marcutudor79/Positive-voltage-regulator/Voltage_regulator_documentation.docx

Project 1

Positive Voltage Regulator

Student: Mărculescu Tudor Coordinators: As. Prof. Laurențiu Teodorescu

Group: 431F Ș.l. Marghescu Cristina

# 1. Project requirements

It is required to design a positive linear voltage regulator with discrete components, with the following specifications:

* Supply voltage between 22 ÷ 25 [V];
* Programmable output voltage 15 ÷ 17 [V];
* The output current through the load between 0 ÷ 34 [mA];
* Short circuit protection of the output terminals with foldback current limiting circuit.
* Overvoltage protection of the output terminals.
* The line regulation factor S=(ΔV_i)/(ΔV_o)|_(RL) ≥ 87.
* Load resistance Rl= (Vo_max)/(Io_max)=500 Ω.

The output impedance of the regulator3 Ω.

The voltage regulator is an electronic device that is supposed to maintain a constant voltage at its output terminal. However, in practice, the voltage regulator reduces drastically the voltage ripple at its input. Therefore, the main characteristic of a voltage regulator is the regulation factor, which tells how much the output voltage changes with respect to the change in the input voltage S=(ΔV_i)/(ΔV_o)|_(RL) . The focus of designing this circuit is to obtain a good enough regulation factor, higher than 100.

The presented regulator is a linear feedback regulator, that employs an active series pass transistor which is controlled by a high gain differential amplifier, which compares the output voltage with a reference voltage and adjust the control device in order to maintain a constant output voltage. It also has the capability to change its output voltage in the range of 15 to 17 V and has a maximum output current of around 34 mA.

# 2. The block diagram of the circuit

The block scheme of the regulator contains at least three main components: the voltage reference, the control element, and the error amplifier. These are essential for the regulator to be able to regulate the voltage. In addition, there is an overcurrent protection that prevents the accidental damage to the series pass transistor, namely the control element. There is also an overvoltage protection and a sampling circuit that provides feedback to the error amplifier, as seen in figure 1.

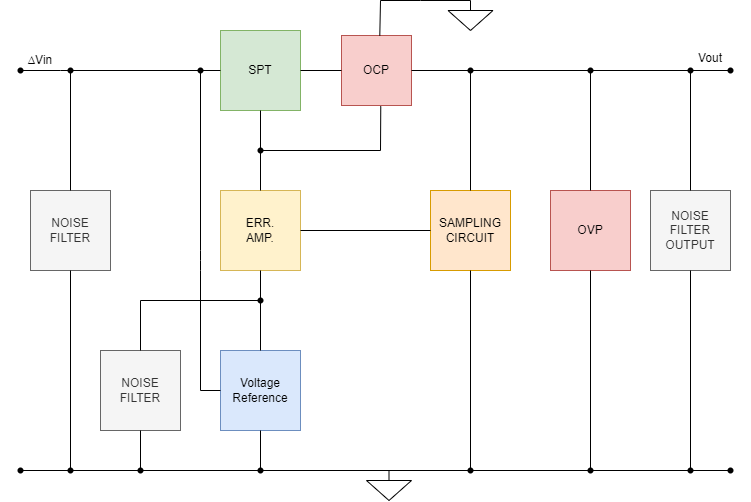
[picture p1: figure]

Figure 1 Block scheme of the positive voltage regulator

The full description of each block in the scheme is to be given in the following paragraph:

- The control element (SPT) is a series pass transistor, that is situated between the unregulated supply and the regulated output. It is controlled by the error amplifier such that to pass a specific a load current, to have the desired output voltage drop on the load.
- The error amplifier (ERR. AMP.) is a differential stage that controls the series pass transistor. It is also connected to the voltage reference and the sampling circuit because this part of the circuit is supposed to compare the reference, which is equal to the desired regulated output voltage and the actual sampled output voltage, that may vary with the different resistances of the loads connected at the output of the voltage regulator.
- The over current protection (OCP) is a stage that is connected in between the series pass transistor and the load. It is supposed to protect the control element from a very high current that can pass through if the output terminals are accidentally short circuited. It also has a special behavior, called foldback, that maintains a lower short circuit current than the maximum current that can pass through this protection. This is an innovative way to implement such a circuit, since the series pass transistor may dissipate a high power for a very short amount of time, but after that it is advised to lower it in order to not overheat the component.
- The over voltage protection (OVP) is the part of the circuit that will not let the output voltage exceed the 18.4V threshold. This circuit is implemented since the purpose of the circuit is to stabilize the voltage up to 17V. It may occur in certain scenarios that the output voltage might spike higher than 17V, therefore a transistor that can sink a current parallel to the load is needed to lower the actual output voltage through the load.
- The sampling circuit is a simple voltage divider that allows the user to program the output voltage by means of a potentiometer. This circuit also has the purpose to employ a negative feedback loop, that helps the overall functioning of the regulator. Because of the feedback, the regulator is able to achieve a higher resistance to noise and the ability to maintain a stable output voltage whatever the resistance of the connected load.
- The voltage reference is the part of the circuit that offers to the error amplifier a constant voltage to which the differential circuit compares the sampled output voltage. This is a critical part of the circuit, since the voltage drop across it must be as stable as possible, for the regulator to have a high regulating factor.
- The noise filters are parts of the circuit that protect that remove the noise from the input and the output of the voltage regulator. They both behave as RC filters with different cutoff frequencies.

CAUTION! Since this circuit employs an over current protection OCP, the resistance of the load must be higher than the minimum allowed resistance through which can pass the maximum allowed current by the OCP.

3. Electrical scheme

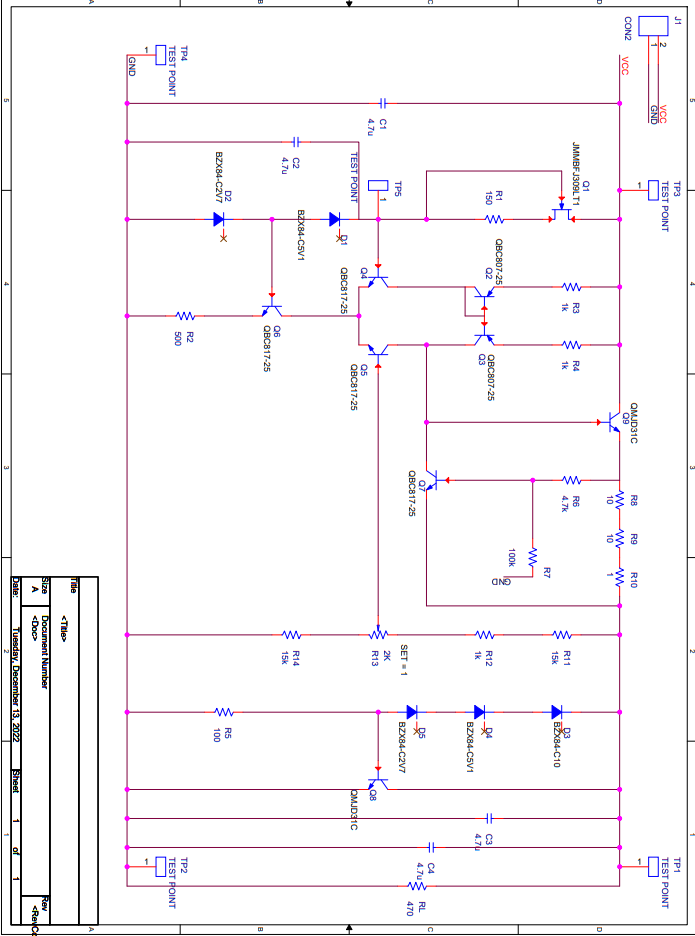
[picture p2: figure]

## 3.1 Details about each block of the circuit

- The voltage reference is the part of the circuit that has a stable voltage drop across at it, even if the input voltage varies. It is used as an input to the non-inverting pin of the differential voltage amplifier, as seen in figure 2.

For this part of the circuit, the Zener diodes D1 and D2, had to have around 7.8V of voltage drop across them, so the BZX84-C5V1 with a Vz = 5.1V and BZX84-C2V7 with a Vz = 2.7V were chosen. In order to obtain those specific Vz voltages, the Zener diodes need to have a minimum current Imin = 5mA to enter the breakdown region. The Imin current will be ensured by Q1, a JFET transistor, JMMBFJ309LT1 that is biased in such a way to obtain a current of 5.6 mA on the branch with the D6 and D2.

It is critical that the current through D6 and D2 does not vary, because if the voltage drop varies on them, then the output voltage will vary too. This is why a simple resistor, on this branch of the circuit, was not acceptable in order to obtain a high regulation factor.

The choice of having around 5.6 mA through the Zener diodes was made since it can be seen on the I-V characteristic that the voltage is more stable if a slightly higher than 5 mA current is passed through them.

- The error amplifier is the part of the circuit that acts as a comparator between the voltage reference and the output voltage of the regulator. It is used in order to obtain a stable output voltage. The error amplifier is composed of a current mirror, represented by Q2 and Q3 PNP transistors, BC807-25, that ensures equal currents that passing through Q4 and Q5 NPN transistors, BC817-25, which compose the differential amplifier stage. They are low power PNP and NPN transistors because the power dissipated by them does not exceed the maximum power that can be dissipated by such transistors according to the data sheet.

The current mirror is an important part of the circuit because it guarantees the fact that the differential amplifier has a higher CMRR and higher bandwidth. The higher CMRR is especially important, because in a noisy environment, this part of the circuit is able to reject some picked up noise that might affect the reference voltage and the sampled output voltage.

To properly equalize the currents that enter Q4 and Q5, transistors Q2 and Q3 need to be matched. However, due to the fact that these are discrete components, and they could have high variations in their process parameters, such as the base-emitter voltage, the resistors R3 and R4 were added in order to neglect those variations. They are both SMD0805.

The error amplifier has at the non-inverting input the voltage reference and at the inverting input the sampled output voltage. By solving this part of the circuit, we can see that the sampled output voltage should be equal with the reference voltage, so this will be ensured by passing to the control element a variable current.

- The control element Q9, MJD31C, is a high power NPN transistor that is biased by the error amplifier. It ensures a proper output current so that the voltage drop across the load is a stable voltage of a particular desired value, in this case, between 15V and 17V. It is proved in the calculus provided below that the dissipated power by this transistor does not exceed its maximum power.
- The over current protection is a circuit made from three sensing resistor R8, R9 and R10, the voltage divider composed of R6 and R7 and the Q7 NPN transistor BC817-25. When the current through the sensing resistors exceeds 60 mA, the Q7 transistor is going to be biased into RAN, therefore sinking the current that would have entered the base of Q9 the control element. This behavior makes Q9 conduct less current, therefore ensuring a maximum allowable current through the control element when the output terminals are short circuited. This circuit also implements the foldback behavior, which makes the short circuit current lower than the maximum allowable current.

Isc < Imax

- The over voltage protection is composed of three Zener diodes BZX84-C10, BZX84C-C5V1, BZX84-C2V7 that do not allow the output voltage to reach a higher value than 18.4V. When reaching this value, the Zener diodes will start conducting and the sense resistor R5 will have a voltage drop across it equal the base emitter voltage of the transistor Q8. If it was previously in the blocking state, the transistor will conduct the “excess” current from the load resistor, therefore stabilizing the voltage drop across it at the maximum 18.4V.
- The sampling circuit is the negative feedback loop for the differential amplifier. It is composed of resistor R11, R12, R14 and the potentiometer R13. Their values have been calculated such that by moving the potentiometer into its minimum value, the output voltage will be equal to 15V and when we move it to the maximum value, the output voltage will be equal to 17V. This allows the output voltage to be programmable.
- The noise filters at the input are the two capacitors at the input C1 that is connected in parallel with the input of the circuit and C2 that is connected in parallel with the reference voltage. They behave as RC filters, where the cutoff frequency of the filter with C1 is dependent on the output impedance of the voltage supply source.

f cutoff = 1/(2πRC)

where C is equal to the capacitance of C1 = 4.7 μF and R is equal to the output impedance of the voltage source

The cutoff frequency of the voltage reference filter has a higher cutoff frequency than the one at the input, since the impedance of R is the impedance of the conductor between D1 and C1.

f cutoff = 1/(2πRC) = 17 kHz

where C is equal to the capacitance of C2 = 4.7 μF and R ≅ 1 Ω

- The noise filter at the output is composed of two parallel capacitors C3 and C4 having a capacitance equal to 9.4 μF. It acts as an RC filter having as R the output impedance of the regulator.

f cutoff = 1/(2πRC) = 17 kHz

## 3.2 Calculus of DC bias, Open-loop voltage gain, closed loop impedance, and the regulation factor

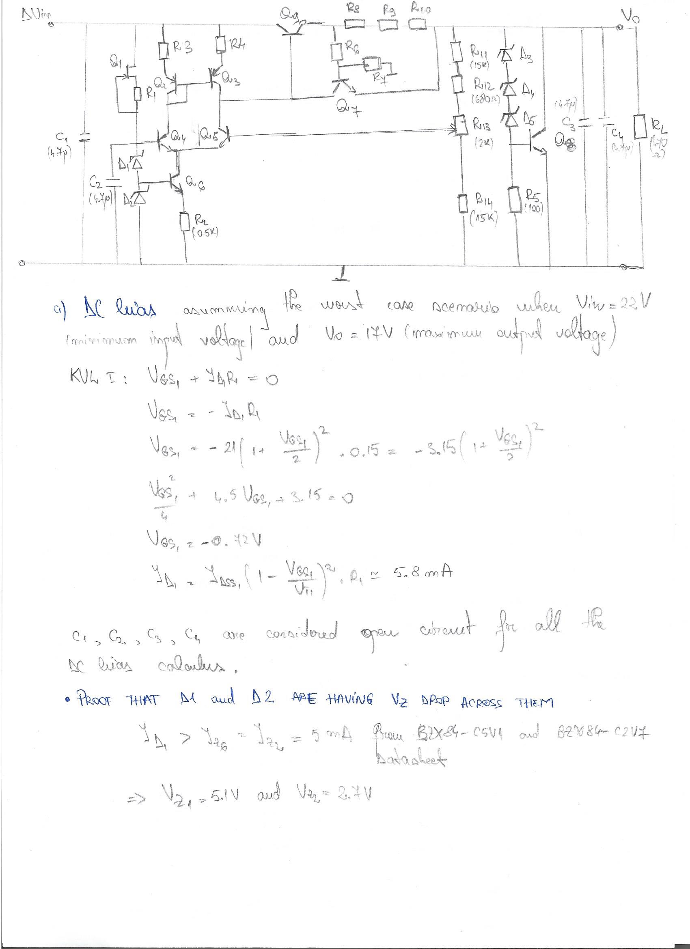
[picture p3: figure]
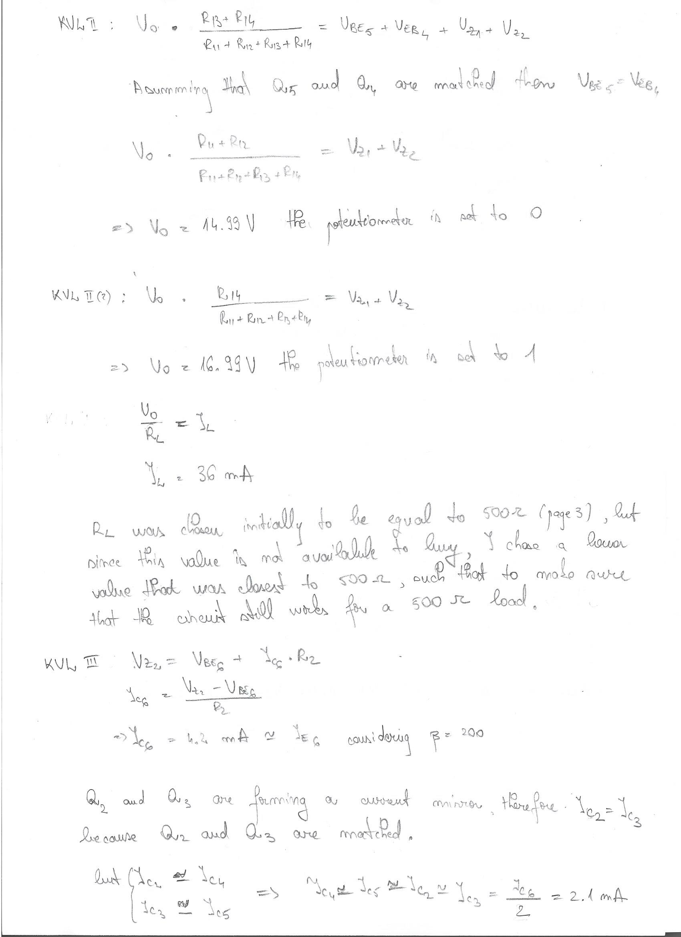
[picture p4: figure]
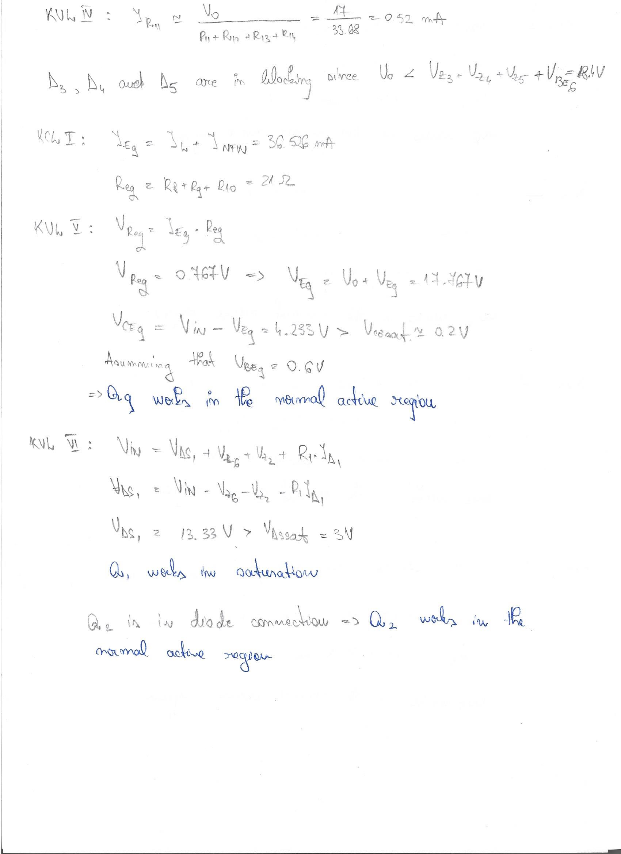
[picture p5: figure]
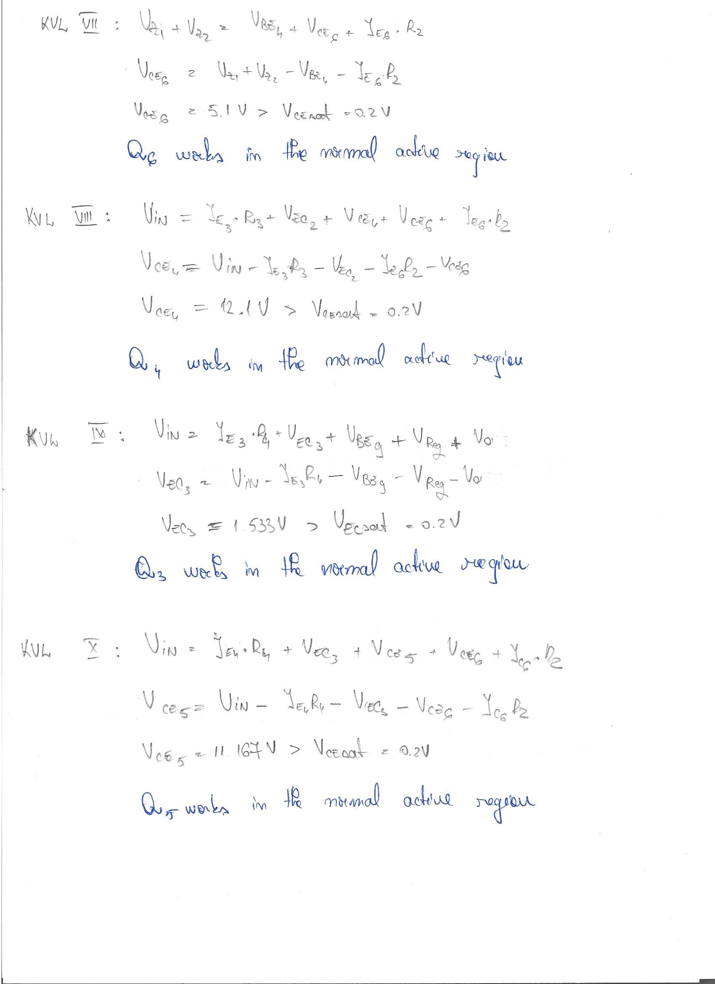
[picture p6: figure]
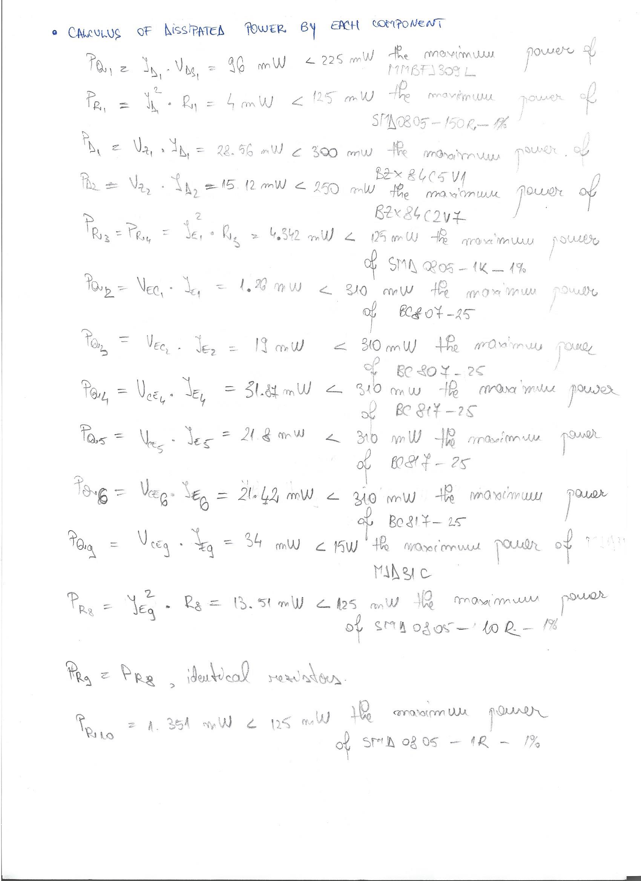
[picture p7: figure]
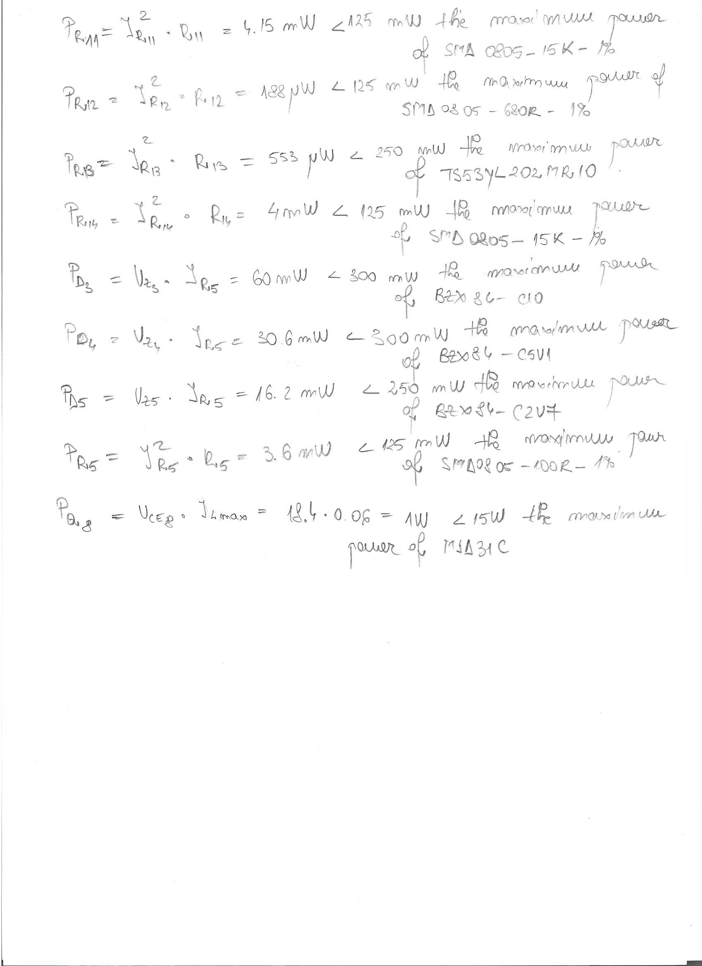
[picture p8: figure]
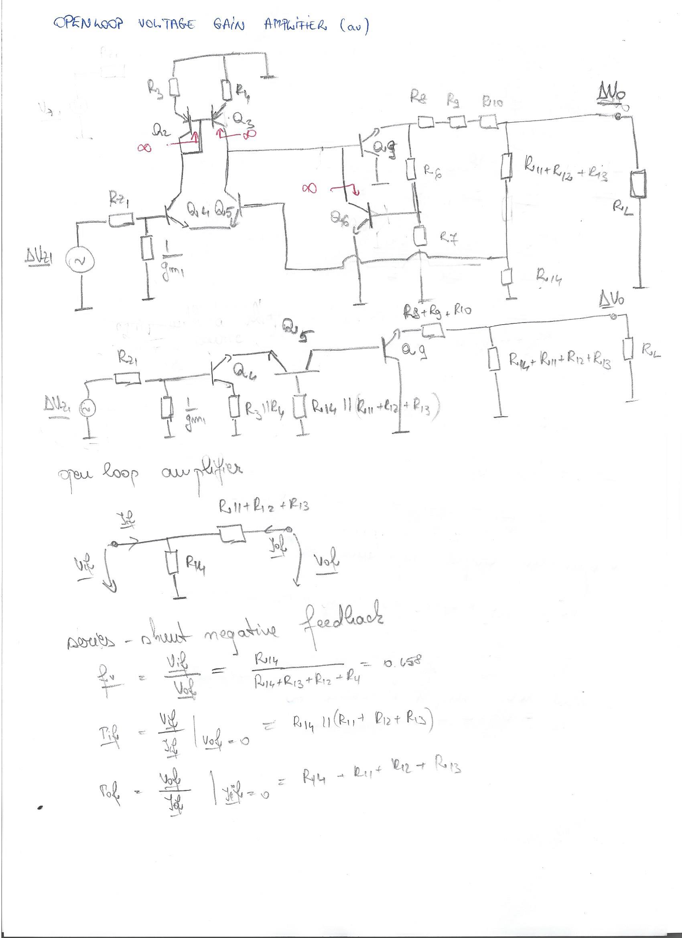
[picture p9: figure]
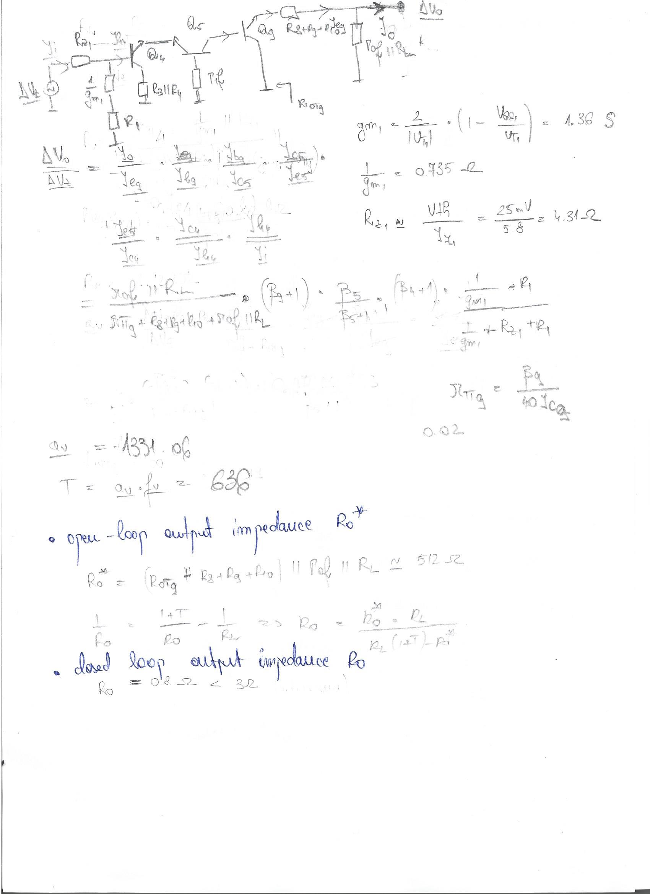
[picture p10: figure]
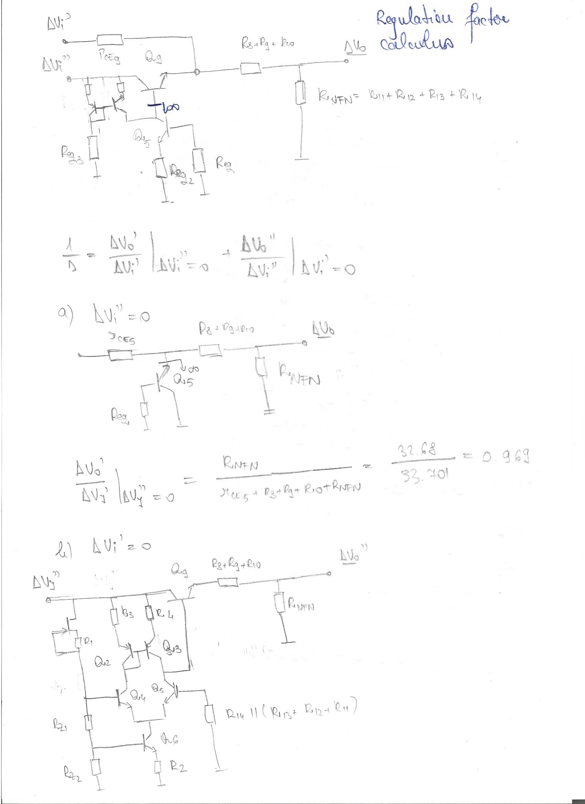
[picture p11: figure]
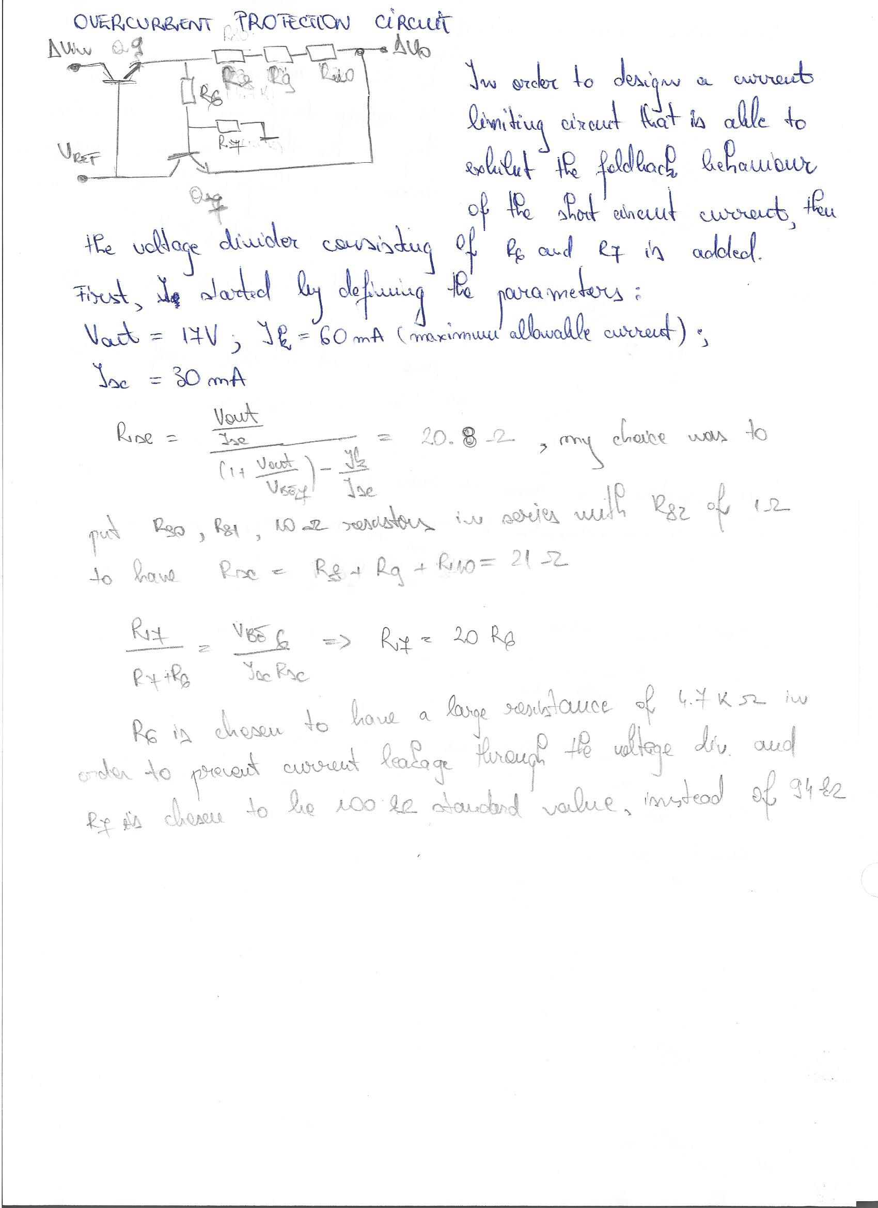
[picture p12: figure]

## 3.3 Calculus of the over current protection OCP

## 3.4 Calculus of the over voltage protection OVP

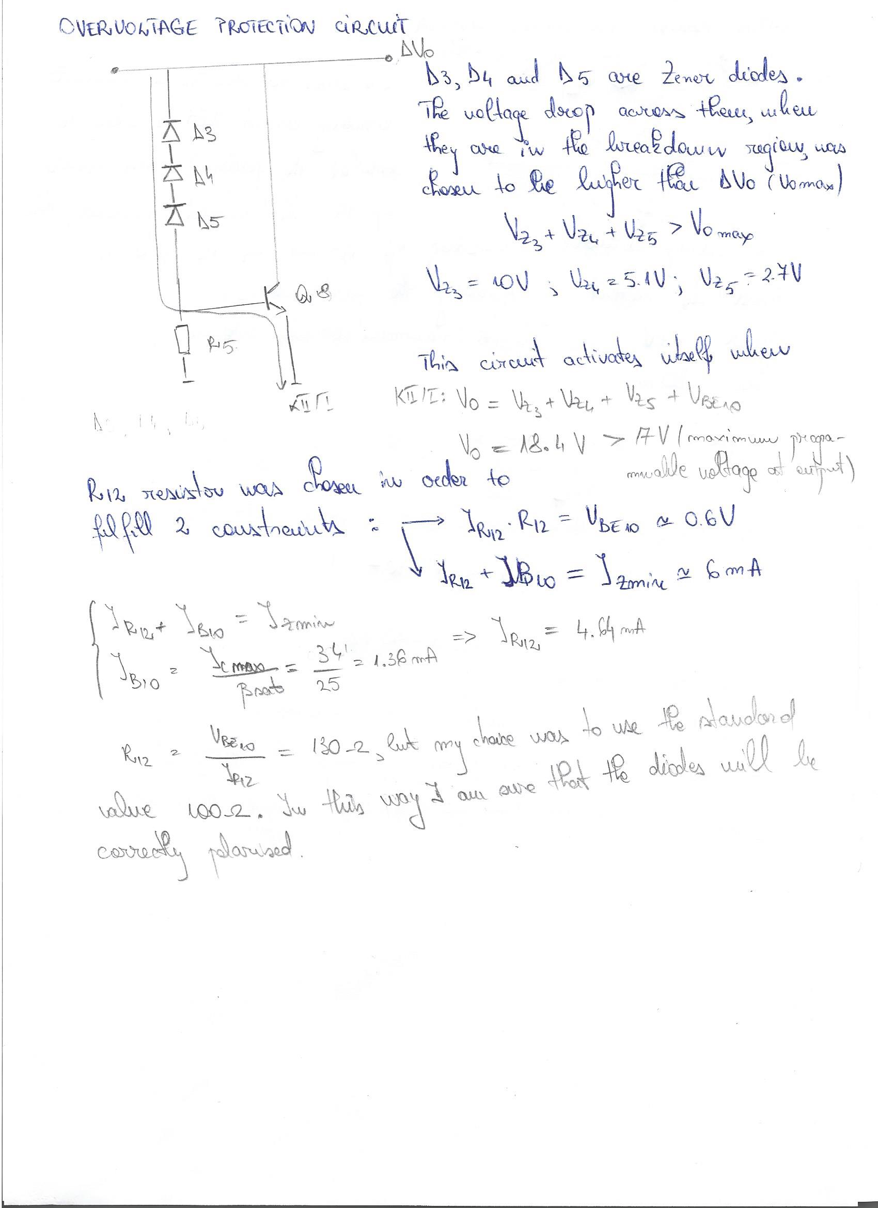
[picture p13: figure]

# 4. SPICE simulations of the circuit

## 4.1 DC bias

The simulation in figure 2 is a bias point one. It is meant to show the overall functionality of the circuit. It is proved that each bipolar junction transistor is working in RAN and the FET transistor is in saturation. The power on each component is also shown, and proves that the maximum power is not exceeded.

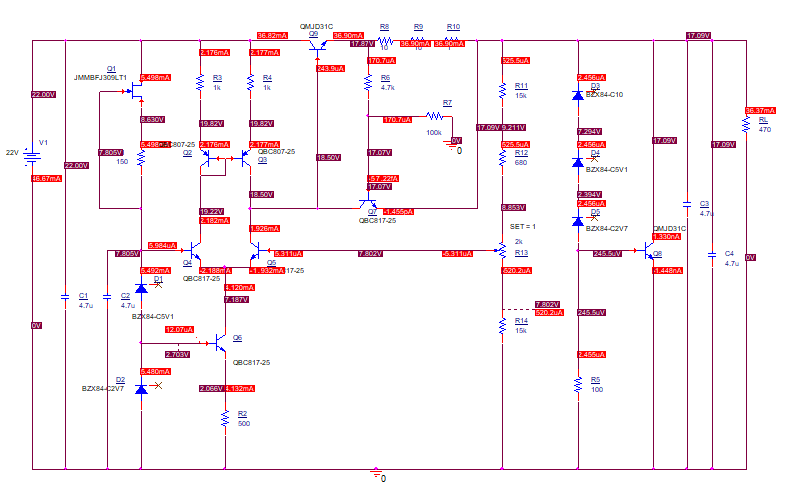
[picture p14: figure]

Figure 2 DC bias in the worst case scenario when Vin = 22V and Vout ≅ 17V

These two DC sweep simulations show that by setting the potentiometer at 0 respectively 1, the circuit can stabilize the voltage at 15V, respectively 17V, which are the required minimum and maximum programmable voltages.

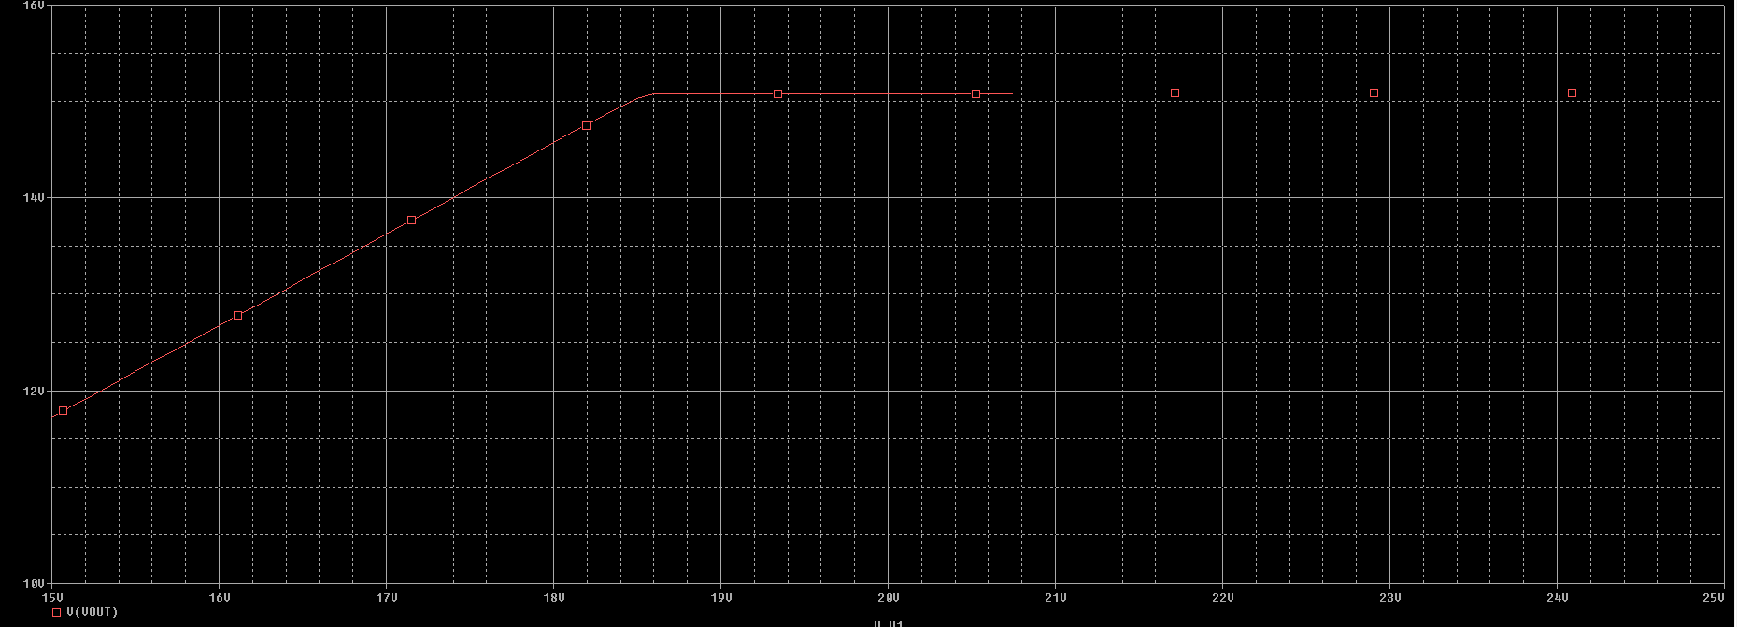
[picture p15: figure]

Figure 3 Minimum required programmable output voltage

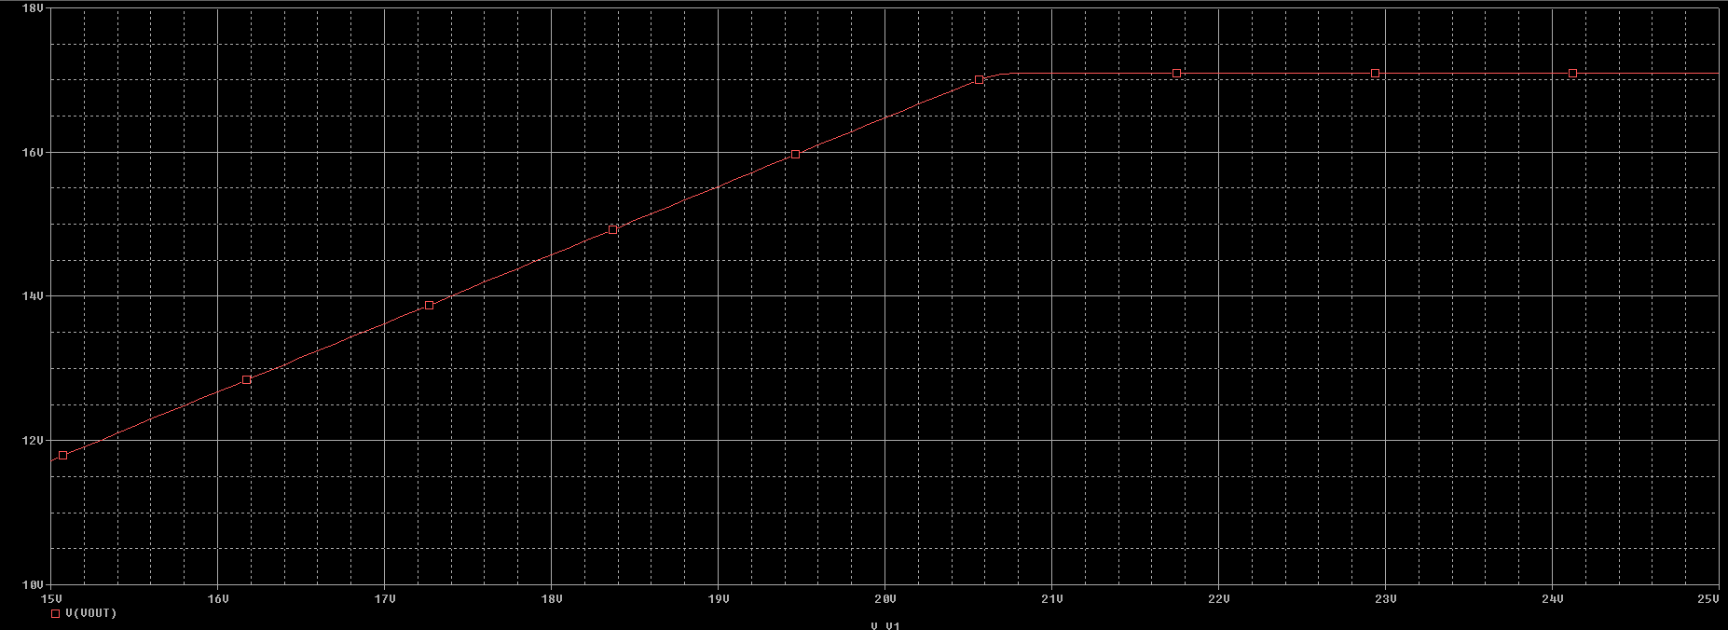
[picture p16: figure]

Figure 4 Maximum required programmable output voltage

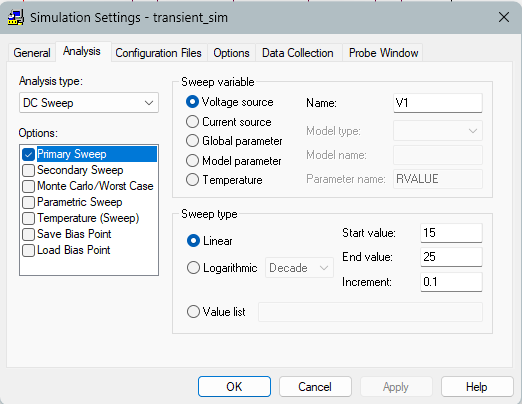
[picture p17: figure]

Figure 5 Maximum / minimum required programmable output voltage simulation settings

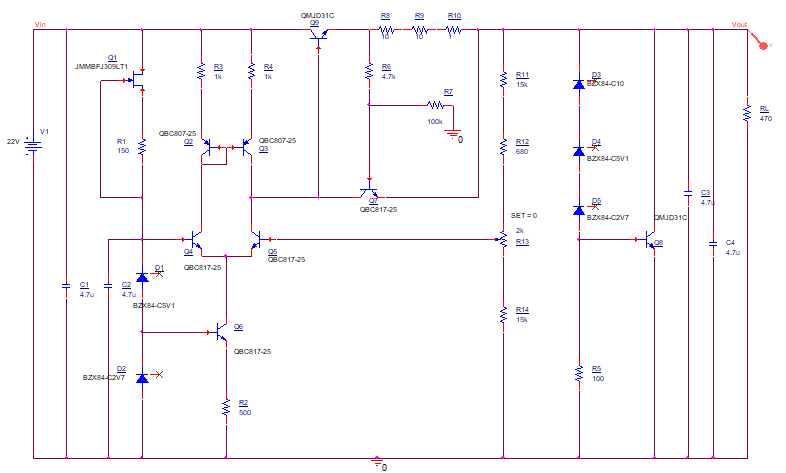
[picture p18: figure]

Figure 6 Maximum / minimum required programmable output voltage circuit configuration

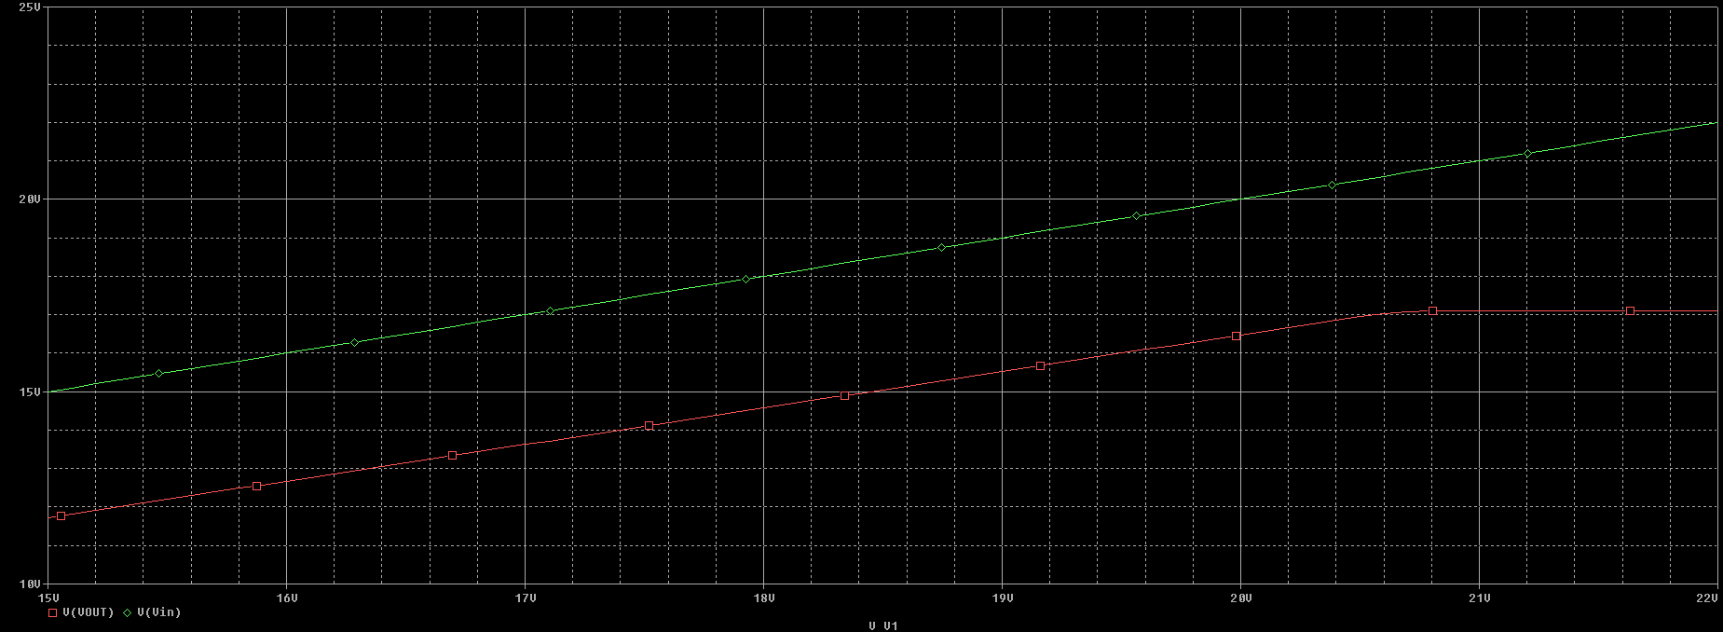
[picture p19: figure]

Figure 7 Worst case scenario when the input voltage is 22V and the output voltage is set to 17V

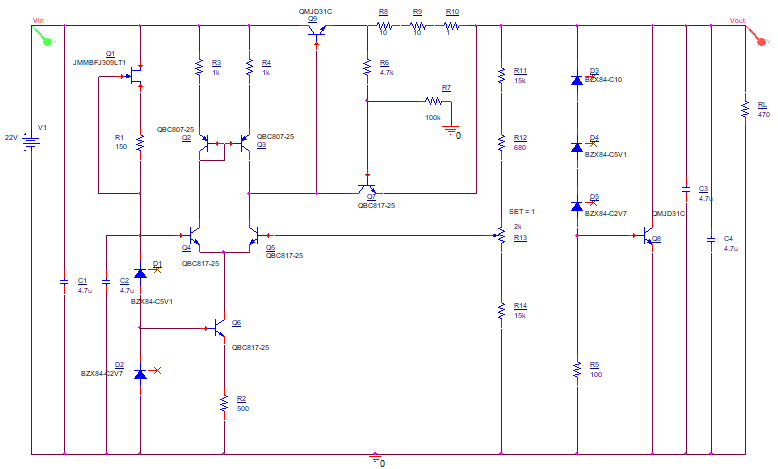
[picture p20: figure]

Figure 8 Circuit used in order to simulate the worst case scenario

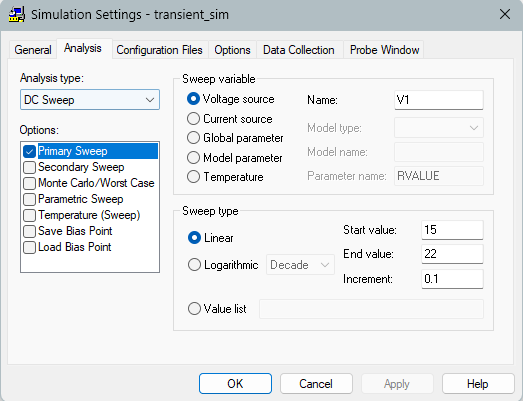
[picture p21: figure]

Figure 9 Simulation settings used to determine the output voltage in the worst case scenario

## 4.2 Stability (S)

The stability is obtained using a transient simulation on a sinusoidal generator. The obtained stability from the simulations is above 600.

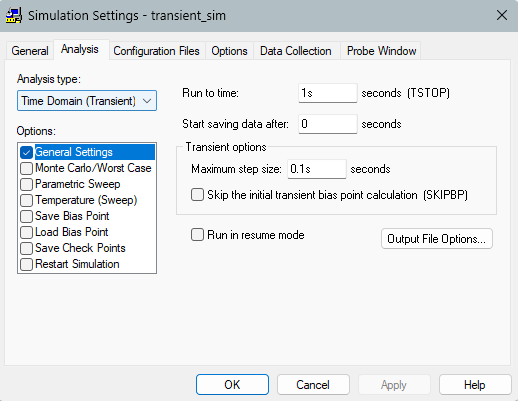
[picture p22: figure]

Figure 10 Settings for simulation in order to determine S

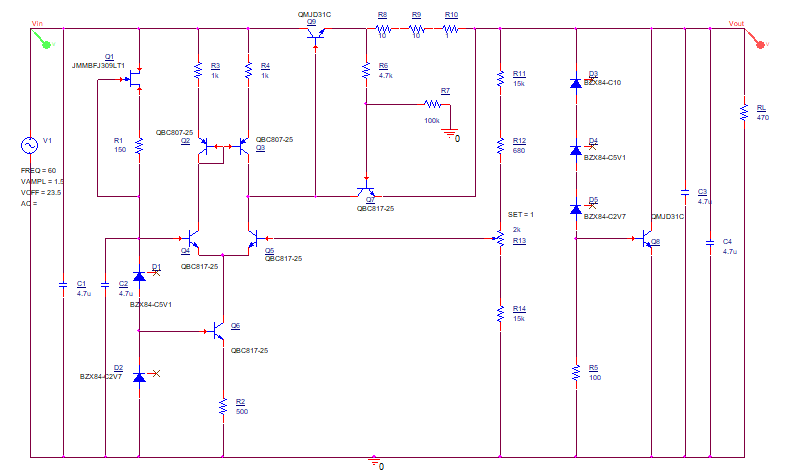
[picture p23: figure]

Figure 11 Circuit that was used in order to determine S

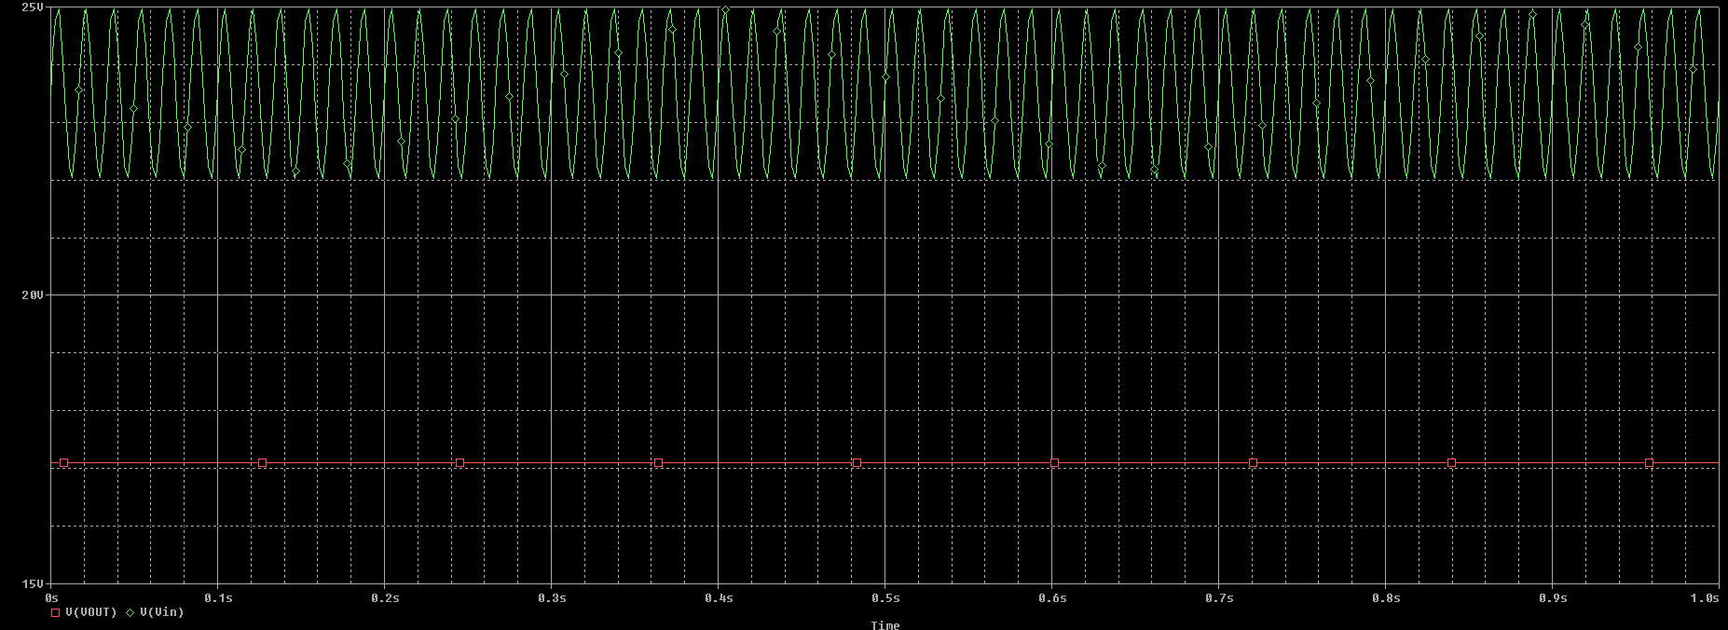
[picture p24: figure]

Figure 12 Variable input voltage(green) compared to the stable output voltage(red)

ΔV_i =3V

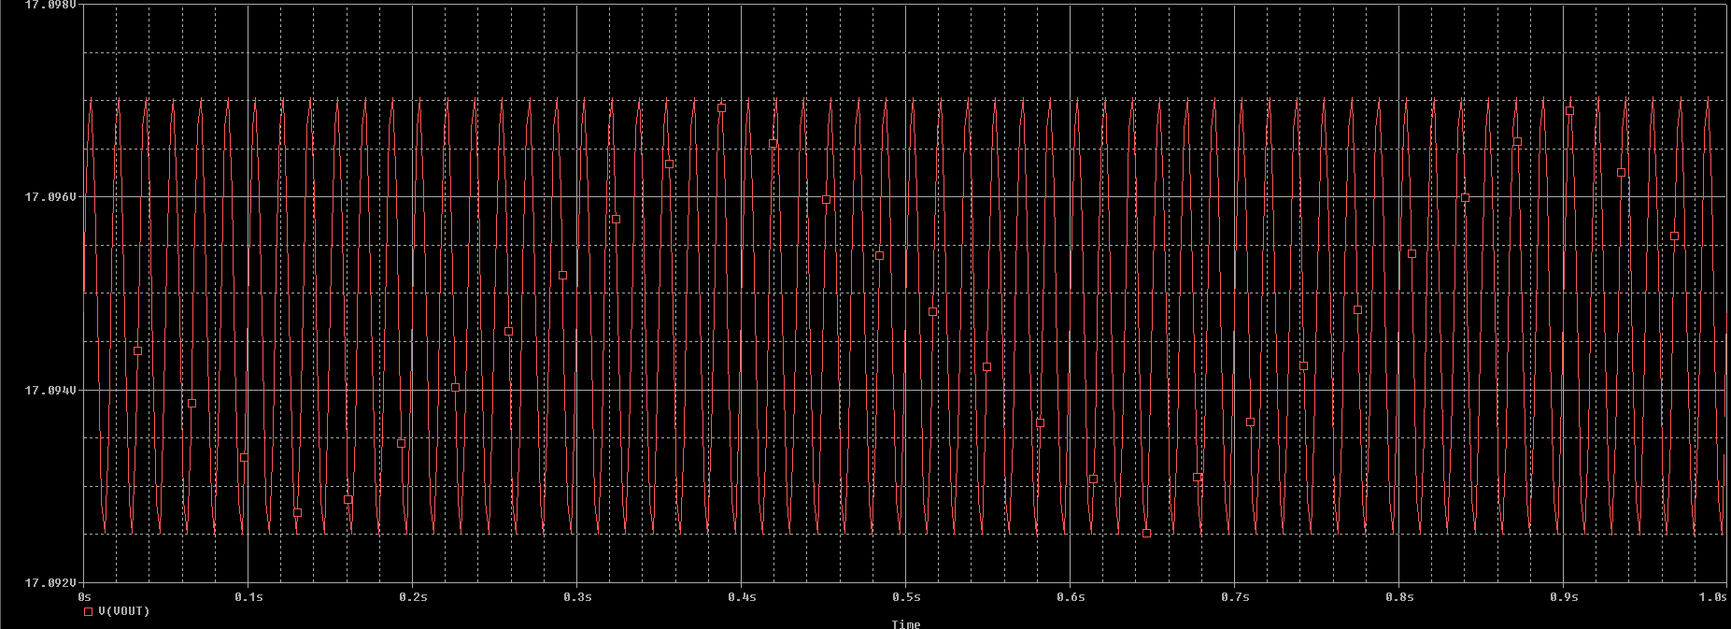
[picture p25: figure]

Figure 13 Actual variation of the output voltage

ΔV_0 = 0.004V

S=(ΔV_i)/(ΔV_o)|_(RL) =750

## 4.3 Closed loop output impedance

The simulation of the closed loop output impedance is not trivial since the circuit has a negative feedback loop. The schematic was modified to be able to simulate the variation of the output voltage when the output current varies between 34mA and 28mA.

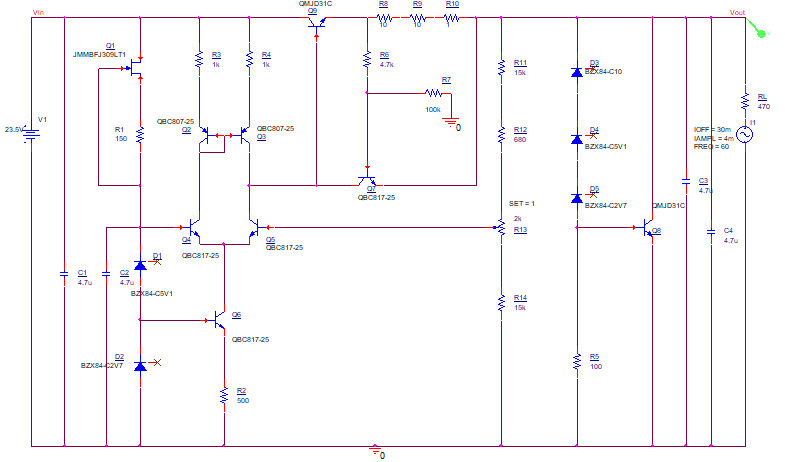
[picture p26: figure]

Figure 14 Circuit used in order to determine the closed loop output impedance

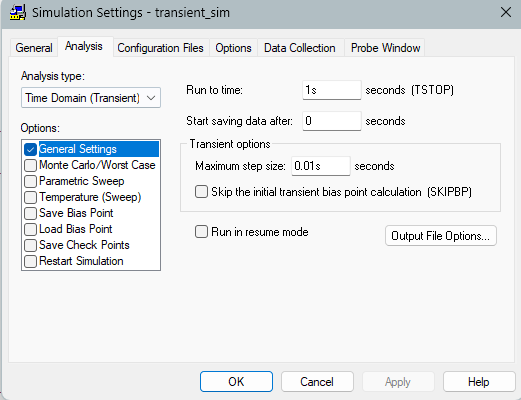
[picture p27: figure]

Figure 15 settings that were used in order to simulate

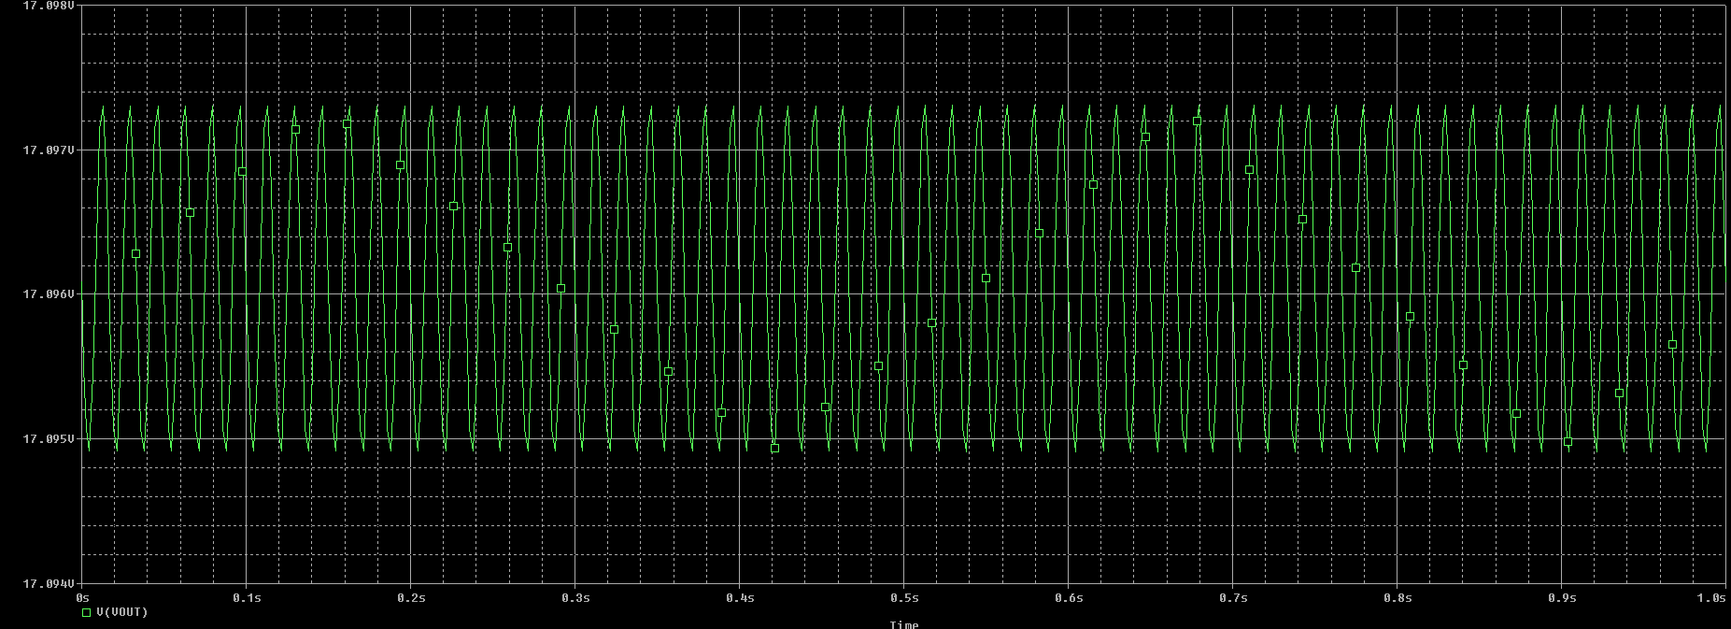
[picture p28: figure]

Figure 16 Variation of the output voltage

One can determine the variation of the output voltage by subtracting the maximum of the sinusoid, which is 17.097 by the minimum 17.095V and obtain a variation of 2mV.

ΔV_o =2 mV

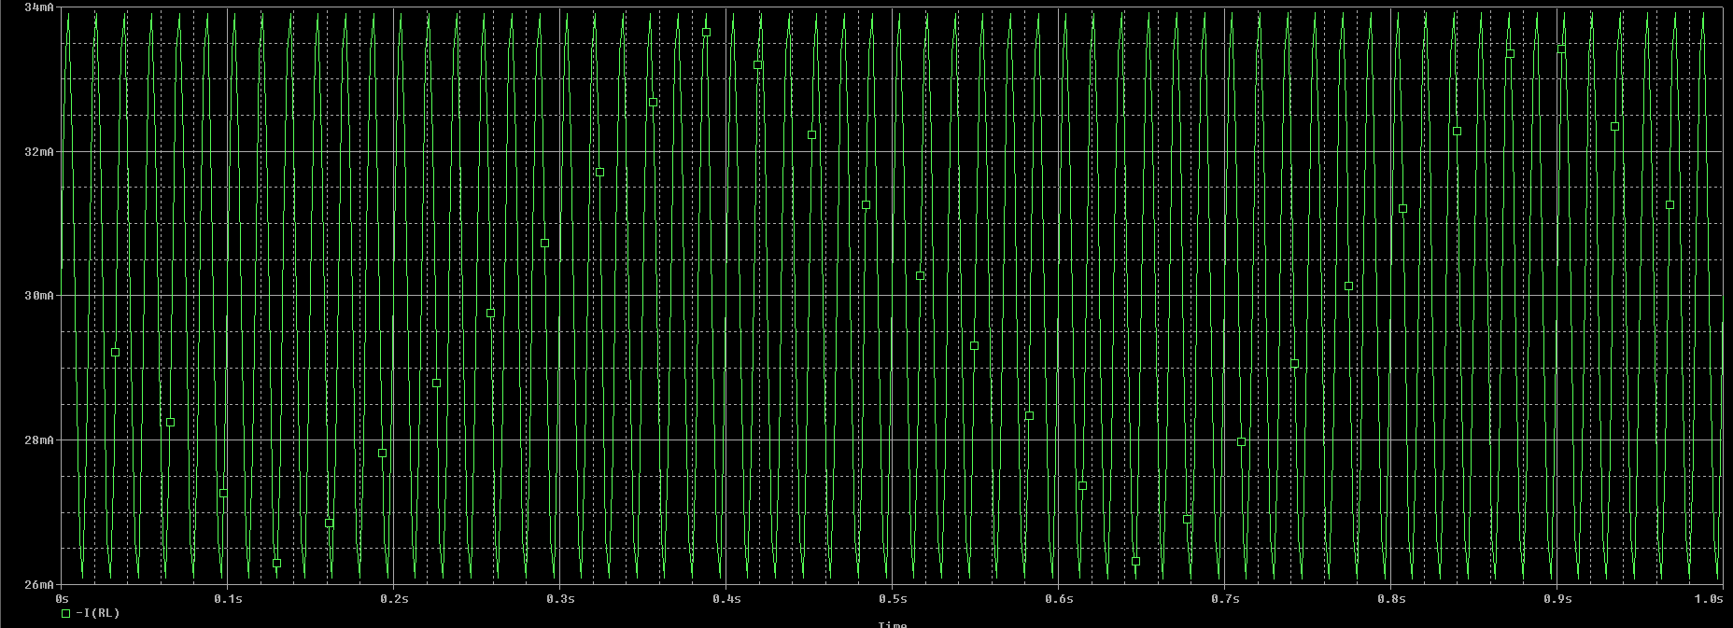
[picture p29: figure]

Figure 17 Variation of the output current

From the graph, one can determine that the variation of the output current is equal to 12 mA.
ΔI_o =8 mA

Ro= (ΔV_o)/(ΔI_o) = 0.25 ohm

## 4.4 Over current protection (OCP)

The simulation of the over current protection is done using a VPWL source at the output of the circuit that T1 = 20 has V1 = 17V and at T2 = 0 has V2 = 0V. This simulates a short circuit at the output of the circuit.

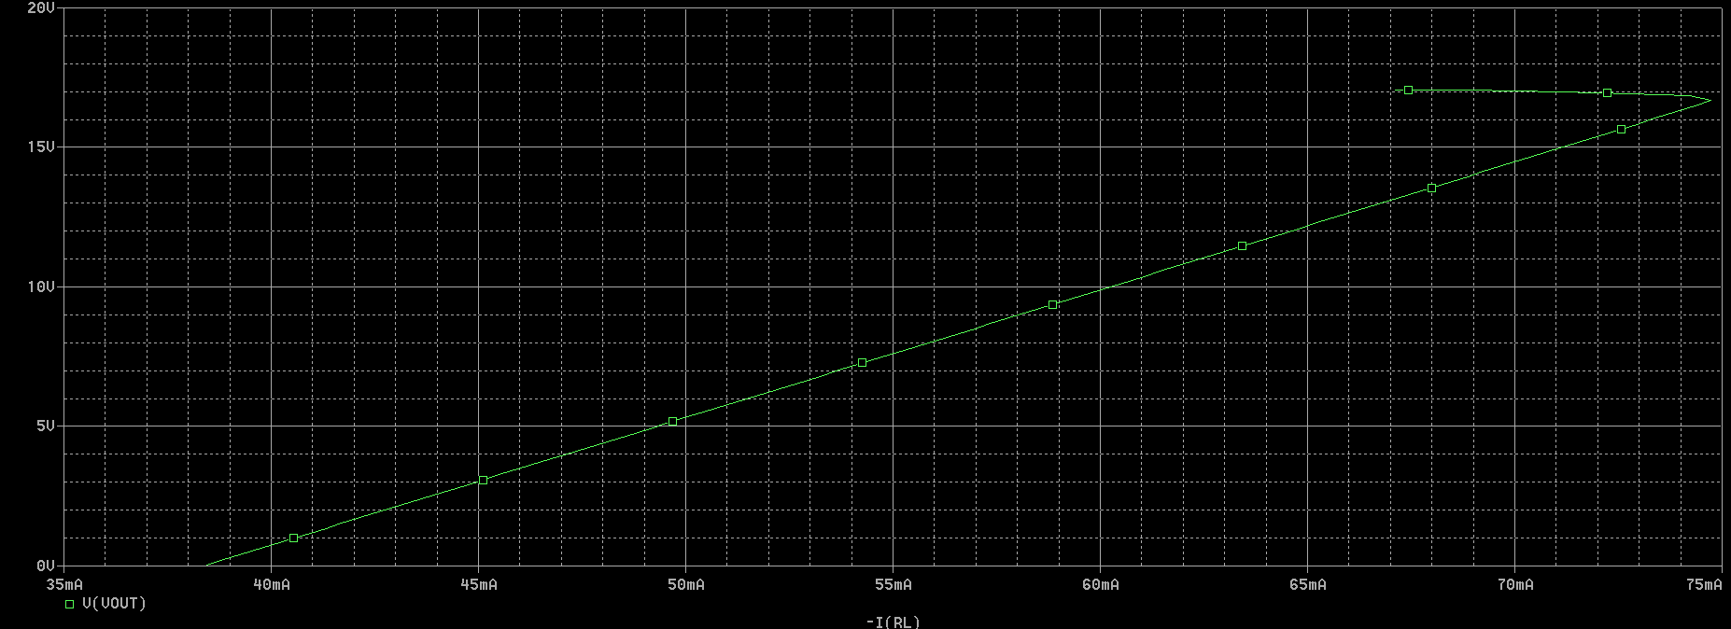
[picture p30: figure]

Figure 18 Overcurrent protection with foldback

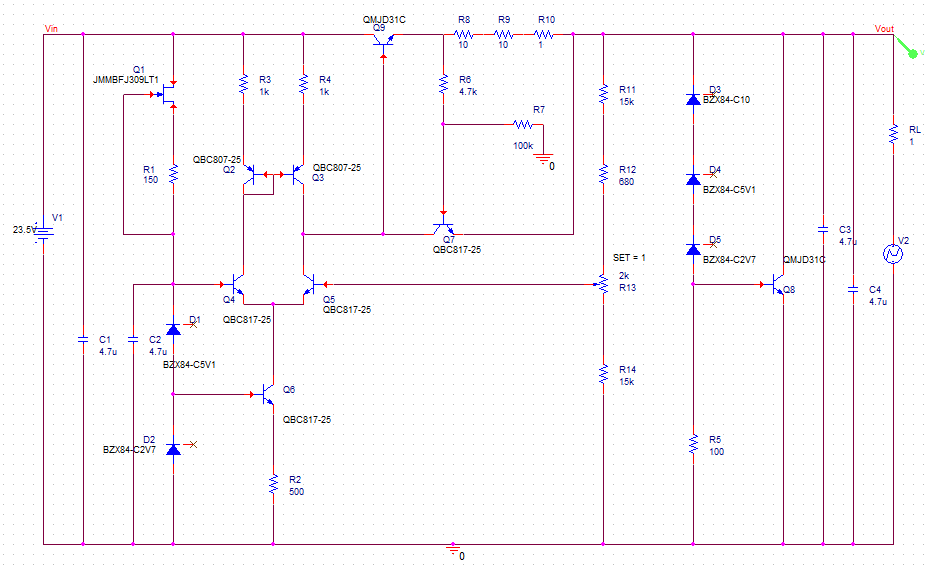
[picture p31: figure]

Figure 19 Circuit used in order to simulate the OCP

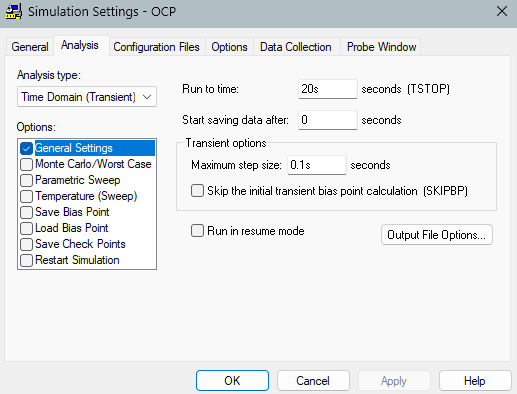
[picture p32: figure]

Figure 20 Settings used in order to simulate the OCP

## 4.5 Over voltage protection (OVP)

The simulation of the over voltage protection is done using a VDC source at the input and by modifying the potentiometer in such a way to have an output regulated voltage higher than 18.4V. Therefore the value of the potentiometer is changed to 5k. This is a DC sweep simulation of the input voltage source between 15V and 25V.

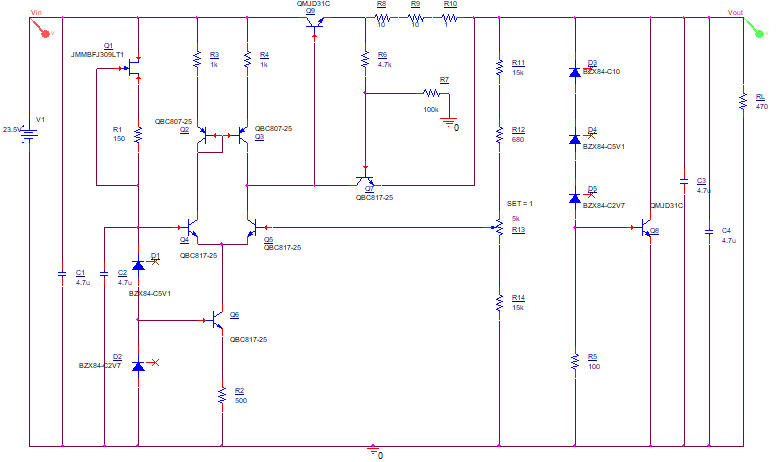
[picture p33: figure]

Figure 21 Circuit used in order to simulate the OVP

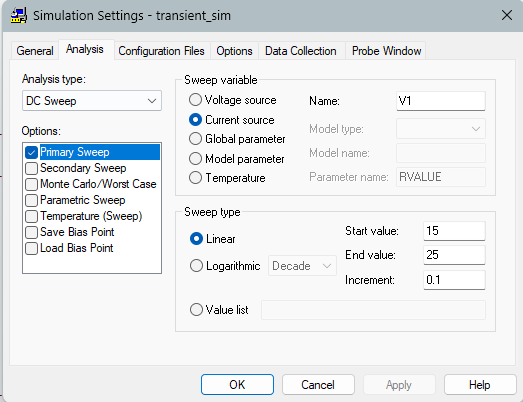
[picture p34: figure]

Figure 22 Settings used in order to simulate the OVP

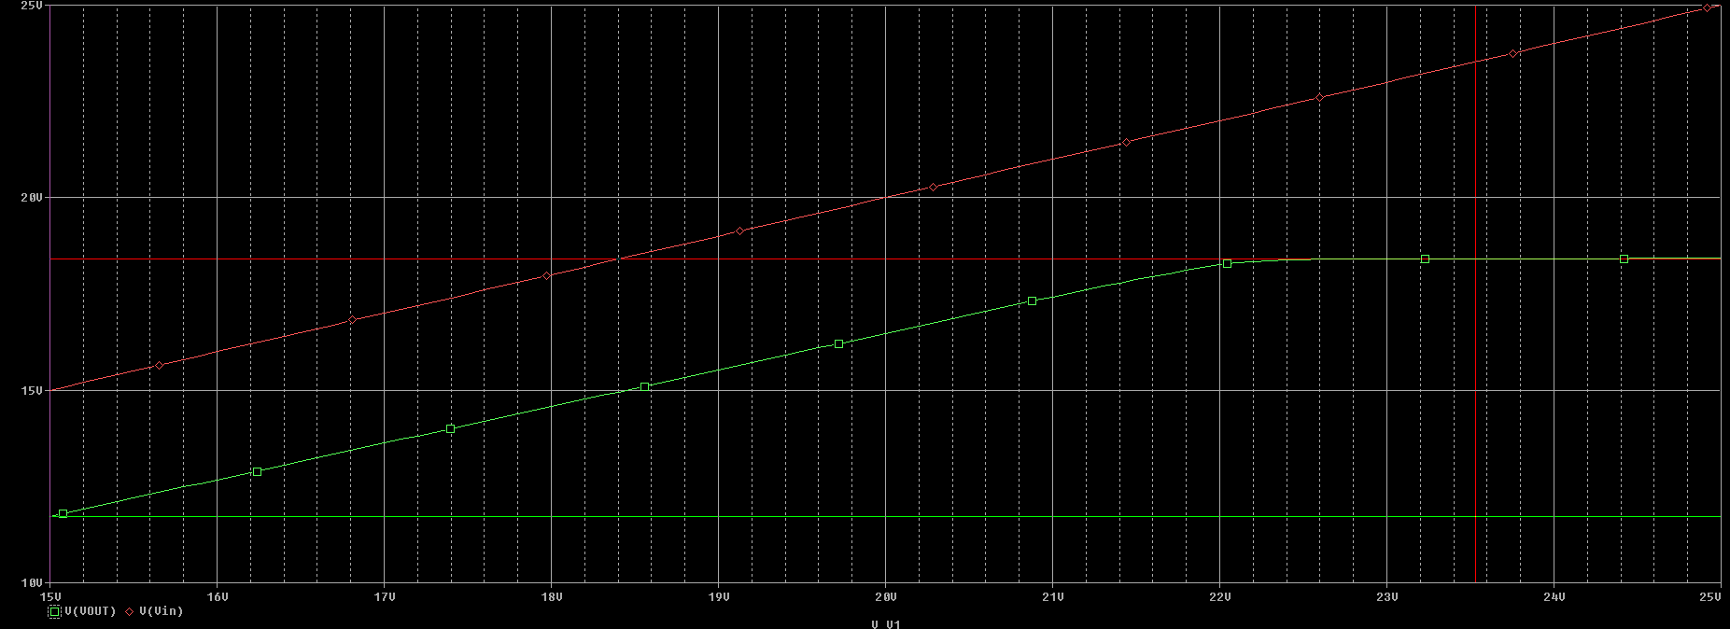
[picture p35: figure]

Figure 23 Output voltage(green) that is limited to 18.4V compared to the input voltage(red)

One can see that the output voltage becomes limited at the 18.4V. This is due to the fact the voltage drop across the Zener diodes in the OVP is 17.8V summed with the voltage drop across the base-emitter of the Q10 when it starts to conduct.

# 5. Conclusions

The purpose of the designed circuit was achieved. It was demonstrated first by means of calculus of all the parameters of the circuit and secondly by simulating them in PSpice in order to demonstrate the correctness of the calculus. Since I did not take into consideration high order effects, some of the obtained values are slightly different in the simulation.

# 6. Layout and mounting map

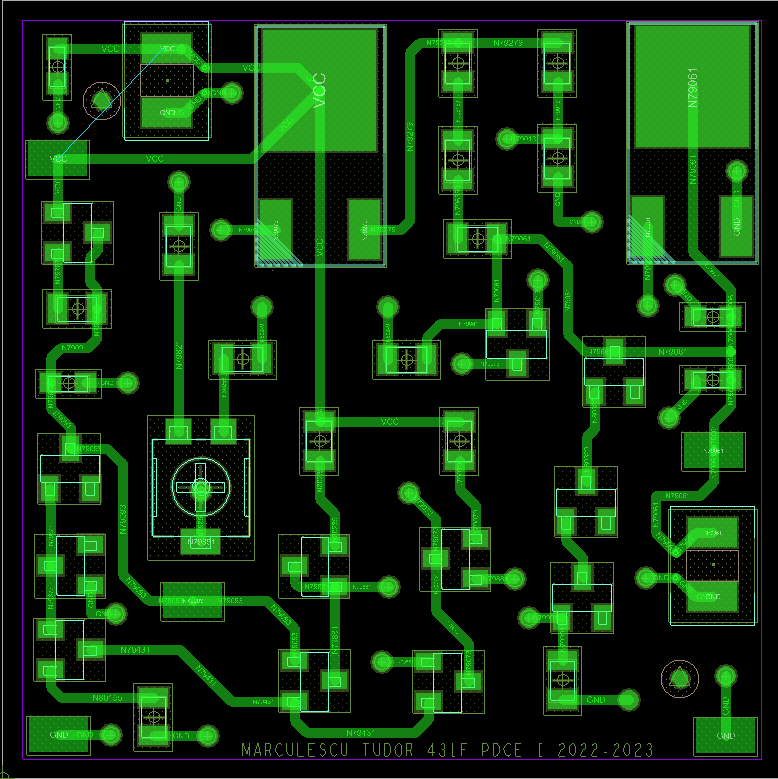
[picture p36: figure]

Figure 24 TOP layer view of the PCB

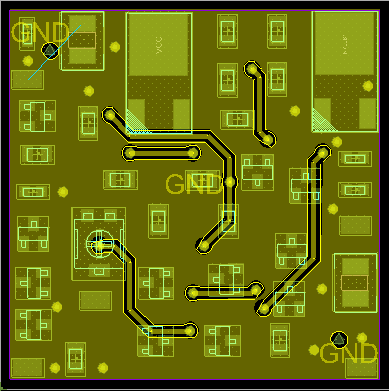
[picture p37: figure]

Figure 25 BOTTOM layer view of the PCB

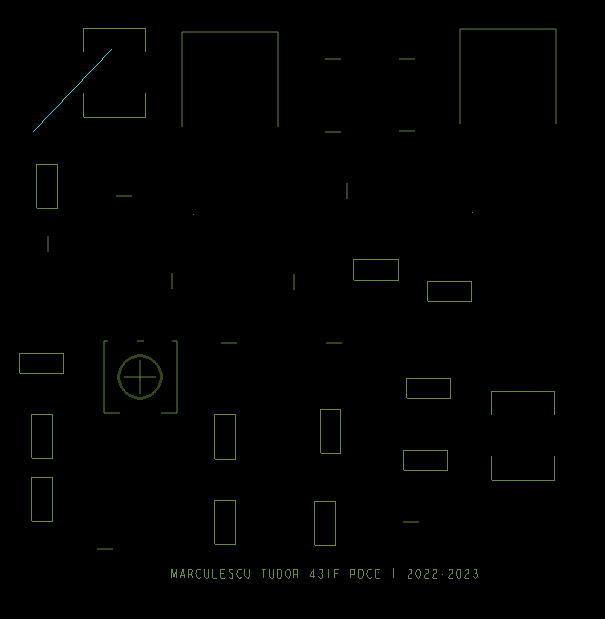
[picture p38: figure]

Figure 26 Silkscreen TOP layer view of the PCB

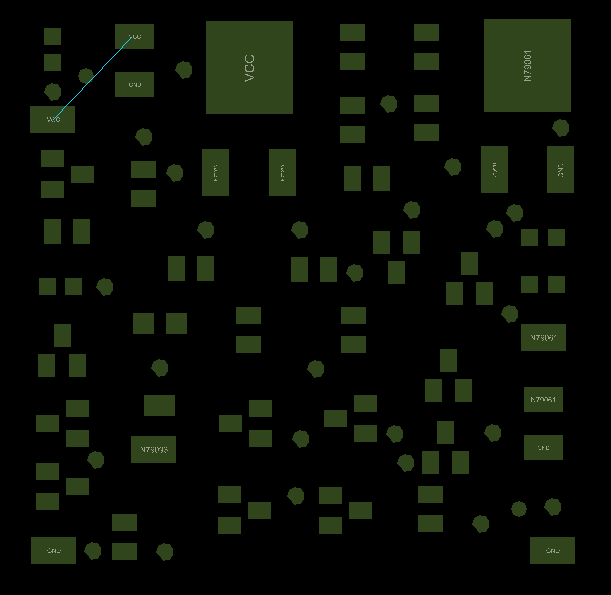
[picture p39: figure]

Figure 27 Soldermask TOP view of the PCB

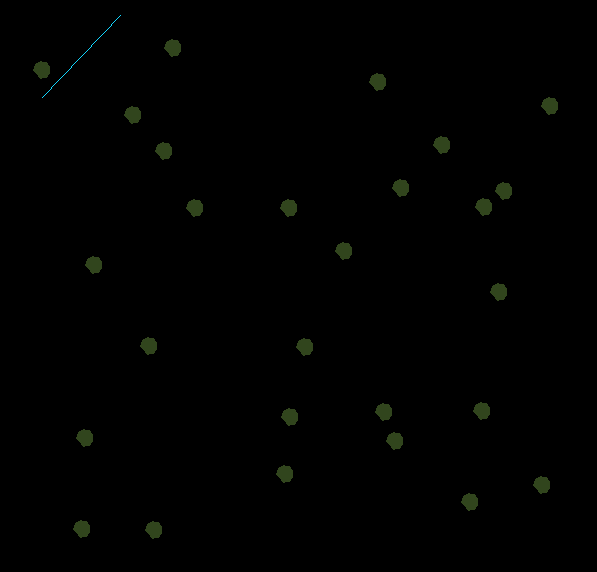
[picture p40: figure]

Figure 28 Soldermask BOT view of the PCB

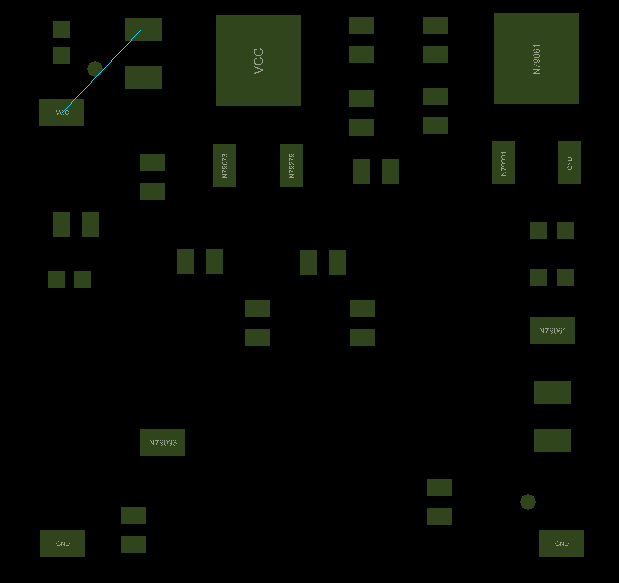
[picture p41: figure]

Figure 29 Soldepaste TOP view of the PCB

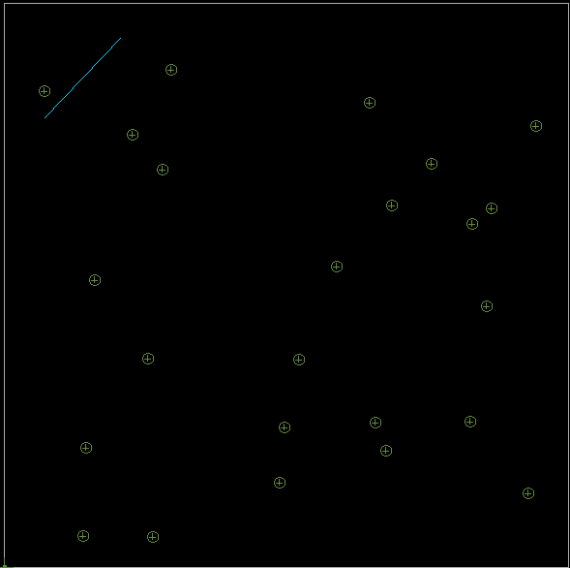
[picture p42: figure]

Figure 30 Mechanical layer view of the PCB

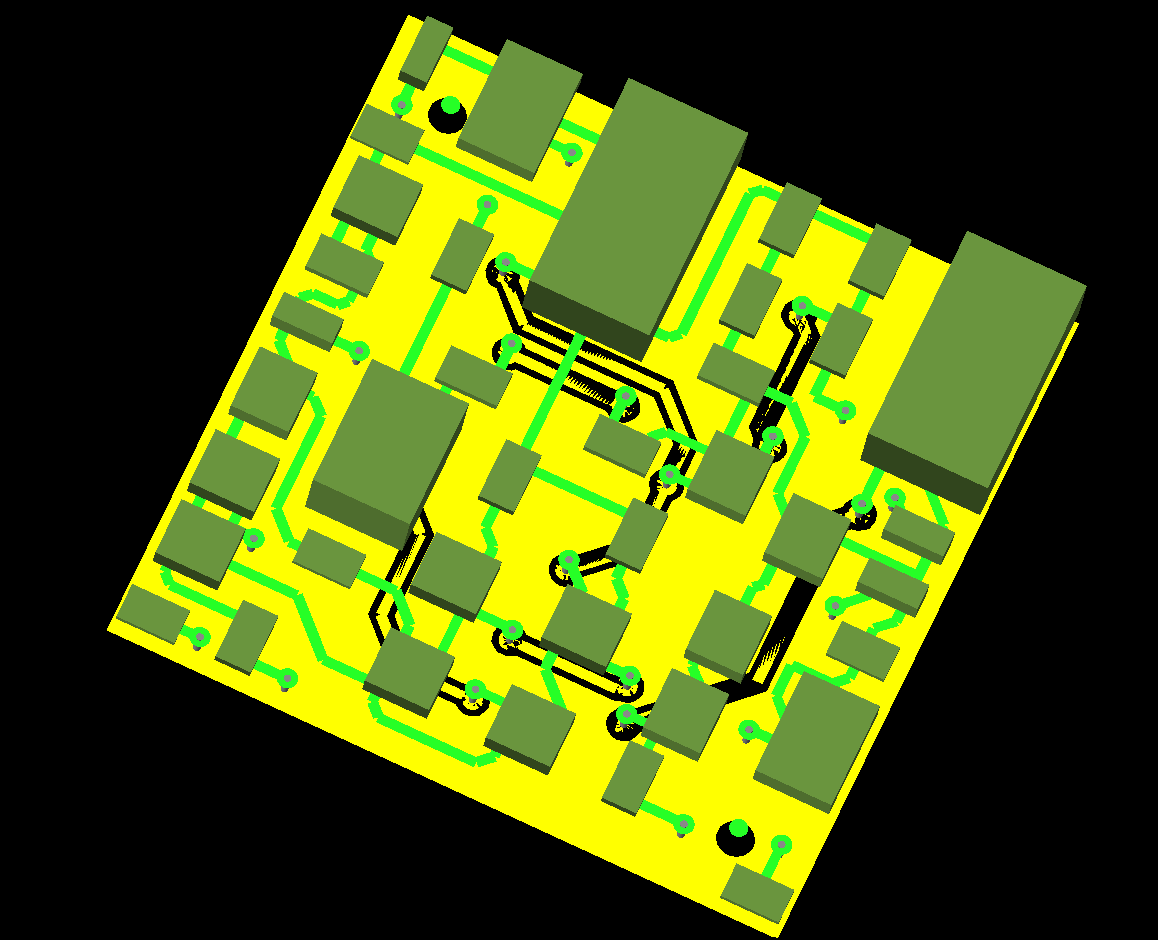
[picture p43: figure]

Figure 31 3D view of the whole PCB

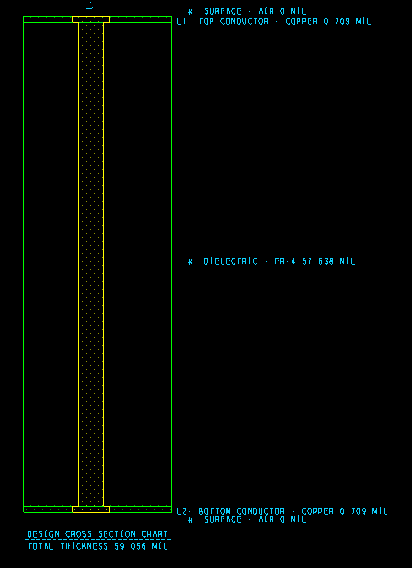
[picture p44: figure]

Figure 32 Cross section of the PCB

Figure 33 Drill chart

## 6.1. User manual

The voltage regulator is a good power supply for low power electronics. It stabilizes the variable input voltage in order to make sure that the circuit, to which it provides stable voltage, will work in the best conditions.

The output voltage is variable from the minimum 15V up to the maximum of 17V. It can be varied by changing the position of the potentiometer.

The maximum output current is 60 mA, however the circuit was designed to work with a load impedance of 500Ω, therefore providing a maximum current of 34 mA.

The circuit has over voltage protection at its output terminals, keeping the voltage at a maximum of 18.4V. It is also equipped with a over current protection with foldback which ensures a maximum short circuit current of around 30 mA.

A minimum input voltage of 22V should be provided to the regulator in order to ensure its best functionality.

A maximum input voltage up to 25V is allowed.

# 7. References

1. Motorola Inc., “LINEAR / SWITCHMODE VOLTAGE REGULATOR HANDBOOK”, 1982 (https://ia800609.us.archive.org/35/items/bitsavers_motoroladaitchmodeVoltageRegulatorHandbook_23523522/1982_Linear_Switchmode_Voltage_Regulator_Handbook.pdf , last accessed 20.11.2022)
2. L. Teodorescu, http://wiki.dcae.pub.ro/images/7/79/Linear_regulator.pdf (last accessed 17.10.2022)
3. L. Teodorescu, Project 1 - Electronic Devices and Circuits, http://wiki.dcae.pub.ro/index.php/Project_1_-_Electronic_Devices_and_Circuits (last accessed 14.11.2022)
4. Integrated analog circuits course, CMOS technology, Faculty of Electronics, Telecommunications and Information Technology
5. Electronic fundamental circuits course, Linear Regulators, Faculty of Electronics, Telecommunications and Information Technology

University POLITEHNICA of Bucharest Faculty of Electronics, Telecommunications and Information Technology
