marcutudor79/Positive-voltage-regulator/(list of files, drawings)

Other design files:
orcad-schematic/POSITIVE_VOLTAGE_REGULATOR_SCH.DSN
orcad-schematic/positive_voltage_regulator_sch.opj
